khjtony/UCDDatalogger/Reporters/March27.pdf

# Data Logger Report

### Tony Kang

### April 4, 2014

## Contents

1 summary | 2
2 Schedule | 3

1

## 1 summary

Now, we have two types of data loggers in testing. One is Arduino UNO with Data Logging shield made by Adafruit. Another one is Arduino Pro mini with some external modules. ”Bare Bone circuit” is not in working now.

### 1.1 UNO with Data logging Shield

Till now, we have a full features data logger which is ”UNO with Data Logging shield”.

1. Advantages:
- It is fast to develop.
- Because this logger is combination of pre-built components, it is more stable during test.
- It can simply mount most of the components on the shield.
2. Disadvantages
- It uses much power, because UNO consume much power and Real Time clock on the Data Logging Shield cannot be shutdown. This system consumes around 50mA during waking up and 30mA during sleeping.
- It has large size.
3. TO-DO:
- Conduct reliable test under different circumsphere, and enhance its robust.

However, generally speaking, this system is good during developing.

### 1.2 Pro Mini with external moduels

Till now, this data logger has full featured program, and its abilities recording 5TE data and battery voltage has been examined, but it has one more test about recording data from ADC circuit.

1. Advantages:
- It consumes less power. One is because that I can manually shutdown external modules including ADC circuit, sensors and Real Time Clock module, which consumes 4mA.

2

- It has flexible physical size, which depends on how we finally put them together.
2. Disadvantages
- It need work when poring program from ”UNO+Shield” to this system.
- It cost more time in debugging.
3. TO-DO:
- Debugging, making system more robust, and conduct reliable test.

## 2 Schedule

1. During spring break, finish of ”UNO with Shield” and upload record.
2. Before April.6, finish debugging of Pro Mini controller and begin robust test.

3
