khjtony/UCDDatalogger/documents/figures/conBrd.png

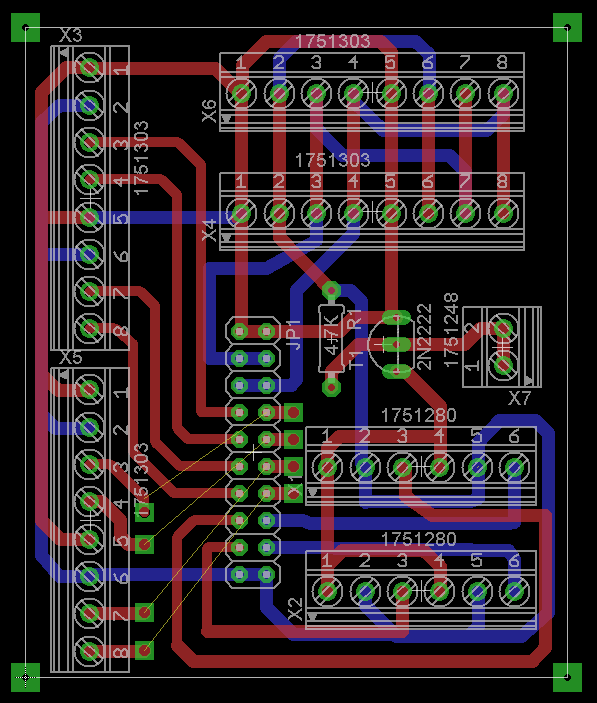
documents/figures/conBrd.png
