khjtony/UCDDatalogger/documents/figures/func_board_top.png

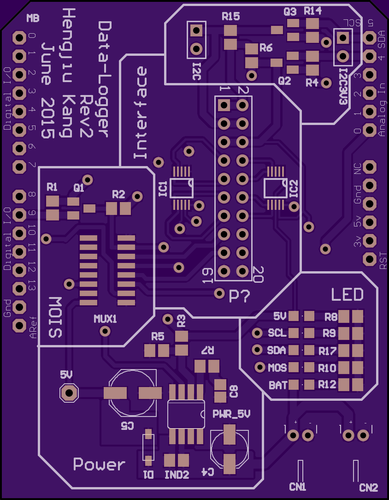
documents/figures/func_board_top.png
