khjtony/UCDDatalogger/documents/figures/uc-davis.jpg

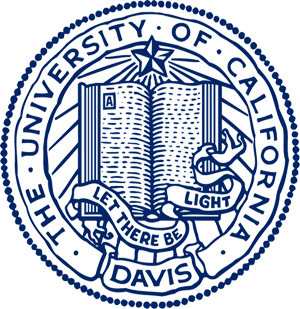
documents/figures/uc-davis.jpg
