khjtony/UCDDatalogger/EthernetShield/H.jpg

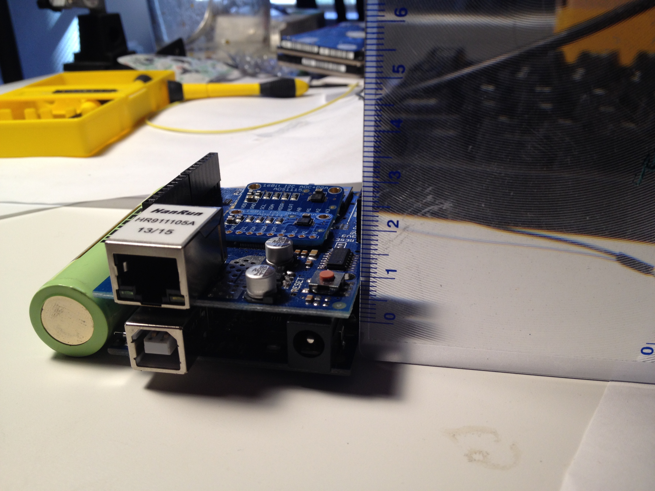
EthernetShield/H.jpg
