khjtony/UCDDatalogger/EthernetShield/L.jpg

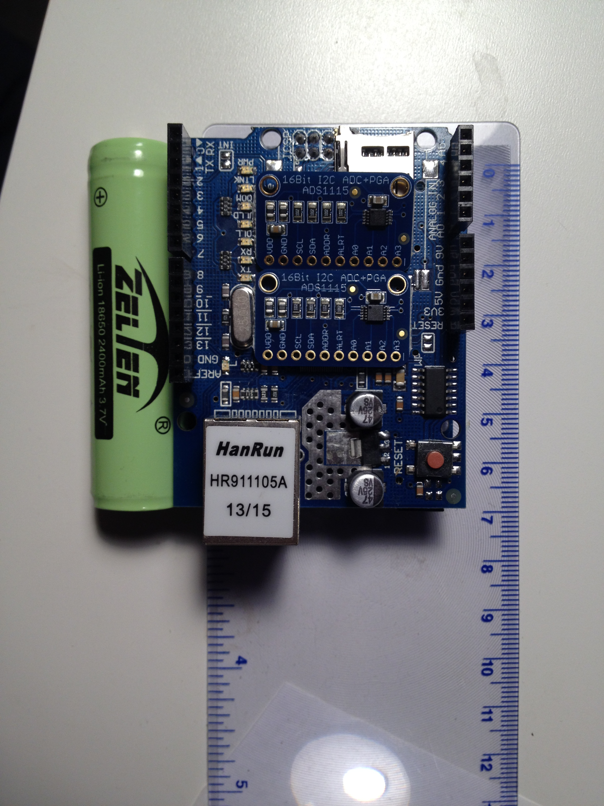
EthernetShield/L.jpg
