khjtony/UCDDatalogger/EthernetShield/W.jpg

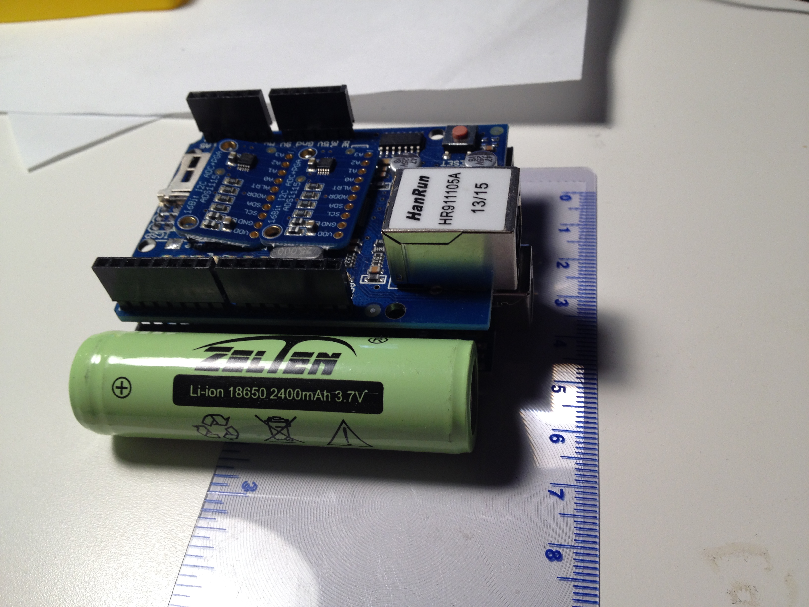
EthernetShield/W.jpg
