khjtony/UCDDatalogger/Reporters/DSC_0035.jpg

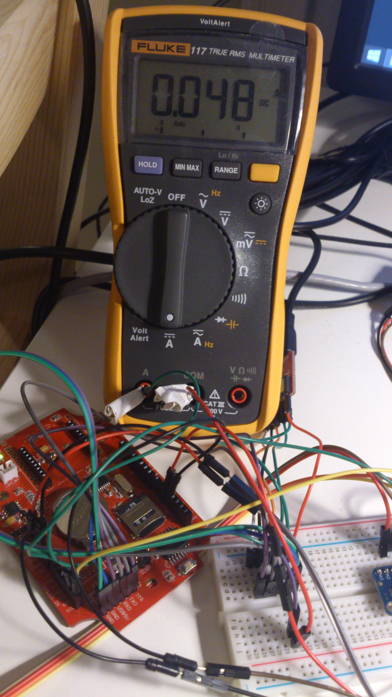
Reporters/DSC_0035.jpg
