khjtony/UCDDatalogger/Reporters/DSC_0037.jpg

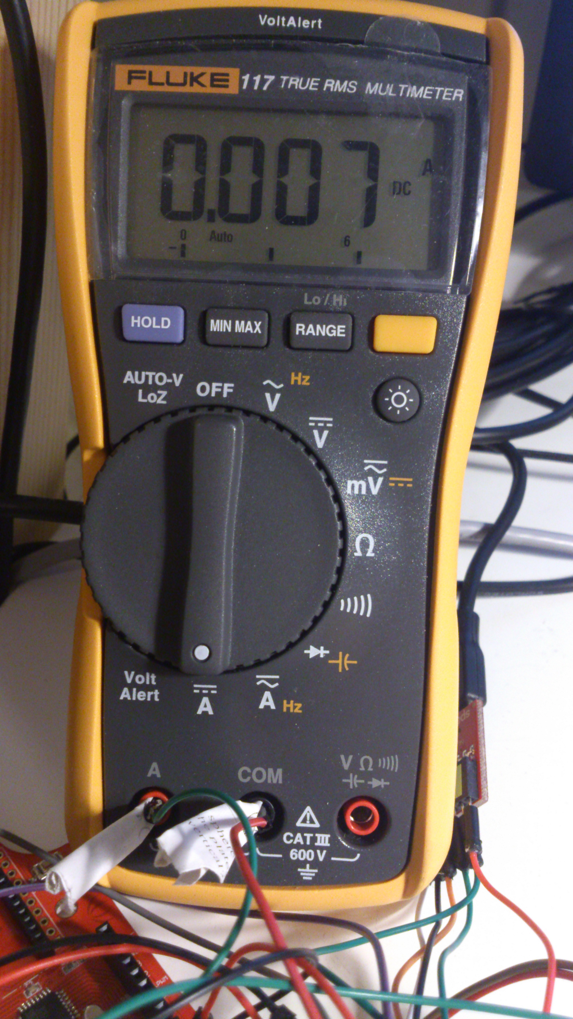
Reporters/DSC_0037.jpg
