khjtony/UCDDatalogger/ShieldBackV01.jpeg

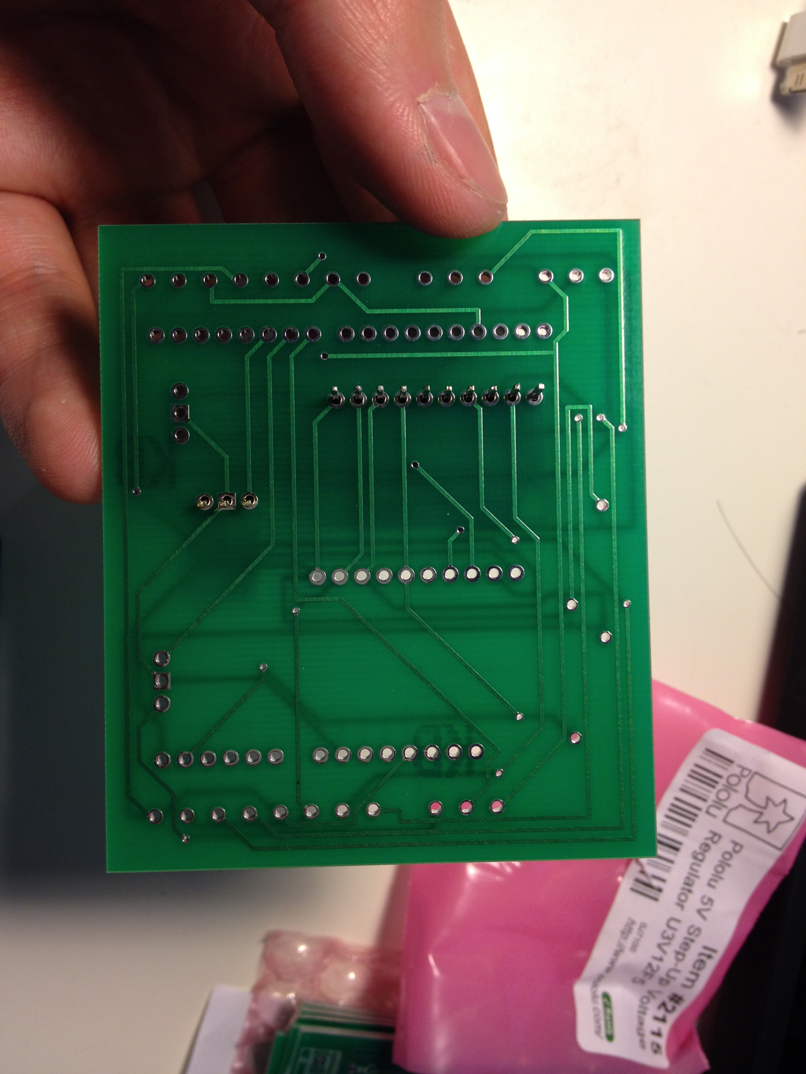
ShieldBackV01.jpeg
