khjtony/UCDDatalogger/XBee900HP.jpg

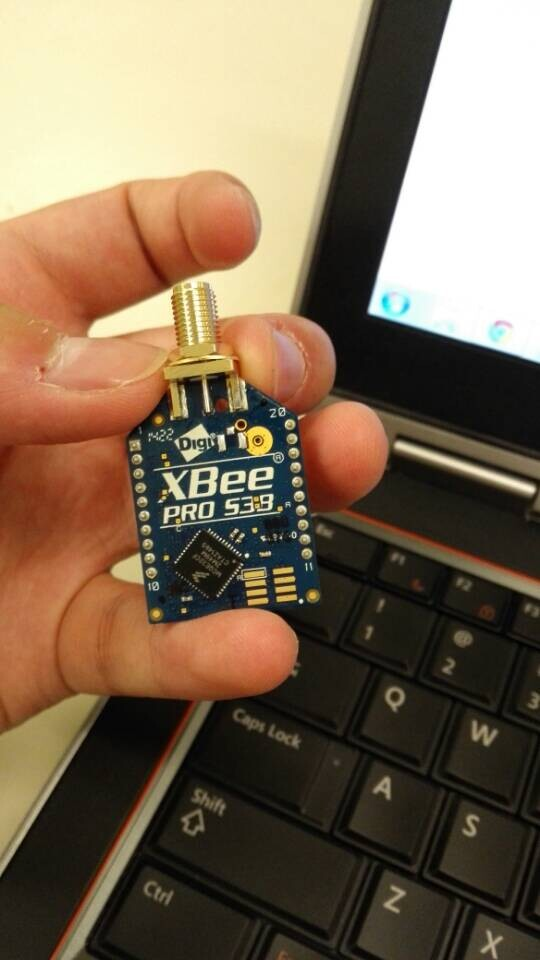
XBee900HP.jpg
