khjtony/UCDDatalogger/xbeeAPItest/allData.png

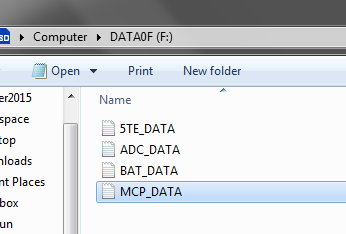
xbeeAPItest/allData.png
