khjtony/UCDDatalogger/documents/BOM_NaughtyBall.xlsx

BOM of Naughty Ball
 |  | Inspection Bill of Materials for : (insert team name/number)
 | Team: | (insert team name) | Team #: |  | Date:
 |  |  | City: |  |  | State:
Item |  | Description | Raw Mat'l | Source | Qty | Unit of Meas | Unit Price ($) | Total Price
Major System Names Here |  | Describe the Part (Axle, Bearing, Lifter, Solenoid) | What is it made from | Where did you buy it (Home Depot, AndyMark, Supply House, Etc.) | How Many | Piece, Inch, Etc. | Cost Per Unit
Controllers:
BeagleBone Black |  | Beaglebone Black Controller |  | Element 14 | 1 |  | $57.99 | $57.99
Arduino Pro Mini |  | Co-processor |  | Adafruit | 1 |  | $9.95 | $9.95
Trinket |  | Co-processor |  | Adafruit | 1 |  | $6.95 | $6.95
 |  |  |  |  |  |  |  | $0.00
 |  |  |  |  |  |  |  | $0.00
 |  |  |  |  |  |  |  | $0.00
 |  |  |  |  |  |  |  | $0.00
 |  |  |  |  |  |  |  | $0.00
 |  |  |  |  |  |  | Subtotals: | $74.89
Sensors
GY-521 |  | IMU from InvenSense |  | Amazon | 1 |  | $5.54 | $5.54
GY-271 |  | Magnetometer from Honeywell |  | Amazon | 1 |  | $5.99 | $5.99
SEN0158 |  | Infrared Cameras |  | DFRobot | 4 |  | $23.55 | $94.20
TSSP4P38 |  | Proximity Sensor |  | Digikey | 8 |  | $1.04 | $8.32
IR67-21C |  | Infrared LED |  | Digikey | 24 |  | $0.21 | $5.04
TCA9548A |  | I2C Mux |  | Digikey | 1 |  | $2.47 | $2.47
LP5907 |  | 3V3 regulator |  | Digikey | 2 |  | $0.61 | $1.22
ADS1015 |  | ADC from TI |  | Digikey | 2 |  | $2.98 | $5.96
LTC4301L |  | I2C Level shift&buffer |  | Digikey | 2 |  | $4.02 | $8.04
 |  |  |  |  |  |  | Subtotals: | $136.78
Mechanical
Transfer unit |  | Ball transfer unit |  | Taobao | 6 |  | $1.60 | $9.60
Transparent Plastic ball |  |  |  | Ebay | 1 |  | $4.00 | $4.00
Plastic Sheet |  | ABS Sheet 200x200x4 mm |  | Taobao | 1 |  | $1.90 | $1.90
Aluminium Sheet |  | Aluminium Sheet 4''x4'' (pack of 6) |  | Taobao | 1 |  | $11.60 | $11.60
Aluminium Sheet |  | Aluminium Sheet 4''x10'x0.064'' |  | Taobao | 1 |  | $3.99 | $3.99
Coupling nuts |  | 8/32 diameter coupling nut |  | Ace Hardware | 4 |  | $0.47 | $1.86
Aluminium Rod |  |  |  | Ace Hardware | 1 |  | $5.65 | $5.65
 |  |  |  |  |  |  |  | $0.00
 |  |  |  |  |  |  | Subtotals: | $38.60
Mobility
Servo Motor |  | Micro Servo Motor |  | Adafruit | 1 |  | $5.95 | $5.95
NCR18650B |  | 3.7V Li-ion battery |  | Amazon | 6 |  | $9.47 | $56.82
Stepper Motor |  | Shinano Kenshi Stepper Motor |  | Taobao | 2 |  | $10.10 | $20.20
Stepper Motor Driver Board |  | TB6560 |  | Taobao | 2 |  | $4.50 | $9.00
 |  |  |  |  |  |  |  | $0.00
 |  |  |  |  |  |  |  | $0.00
 |  |  |  |  |  |  |  | $0.00
 |  |  |  |  |  |  |  | $0.00
 |  |  |  |  |  |  | Subtotals: | $91.97
PCB and Other
Shield |  | Shield PCB |  | Bay Area Circuit | 1 |  | $30.00 | $30.00
Ankle Band LED |  | PCB for Ankle band LED |  | Bay Area Circuit | 1 |  | $30.00 | $30.00
NeoPixel |  | LED Strip |  | Adafruit | 4 |  | $9.95 | $39.80
3D print fillment |  | PLA 3D printing fillment |  | Ebay | 1 |  | $20.00 | $20.00
Ankle Band Driver |  | PCB for driving LEDs |  | Bay Area Circuit | 1 |  | $30.00 | $30.00
LM2596 |  | Adjustable Swtich Regulator |  | Taobao | 1 |  | $0.50 | $0.50
 |  |  |  |  |  |  |  | $0.00
 |  |  |  |  |  |  |  | $0.00
 |  |  |  |  |  |  | Subtotals: | $150.30
 |  |  |  |  |  |  | Totals: | $492.54
