khjtony/UCDDatalogger/(list of files, drawings)

Other design files:
KLogShield/KLogShield/interfaceBoard.SchDoc
KLogShield/KLogShield/KLogShield.PcbDoc
KLogShield/KLogShield/KLogShield.PrjPcb
KLogShield/KLogShield/KLogShield.SchDoc
KLogShield/KLogShield/KLogShield_MB_Rev1.PcbDoc
KLogShield/KLogShield/KLogShield_Rev1.SchDoc
KLogShield/KLogShield/shield_main.SchDoc
KLogShield/KLogShield/sub_moisture.SchDoc
KLogShield/KLogShield/sub_pressure.SchDoc
KLogShield/KLogShield/sub_temperature.SchDoc
KLogShield/KLogShield_Interface_Rev1/KLogShield_Interface_Rev1.PrjPcb
KLogShield/KLogShield_Interface_Rev1/KLogShield_Interface_Rev1.SchDoc
MUXShield/MUXShield.DSN
MUXShield/MUXShield.pdsprj
