khjtony/UCDDatalogger/KLogShield/InterfaceEagle/interfaceBoard.brd

## EAGLE design KLogShield/InterfaceEagle/interfaceBoard.brd (2015-07-22)

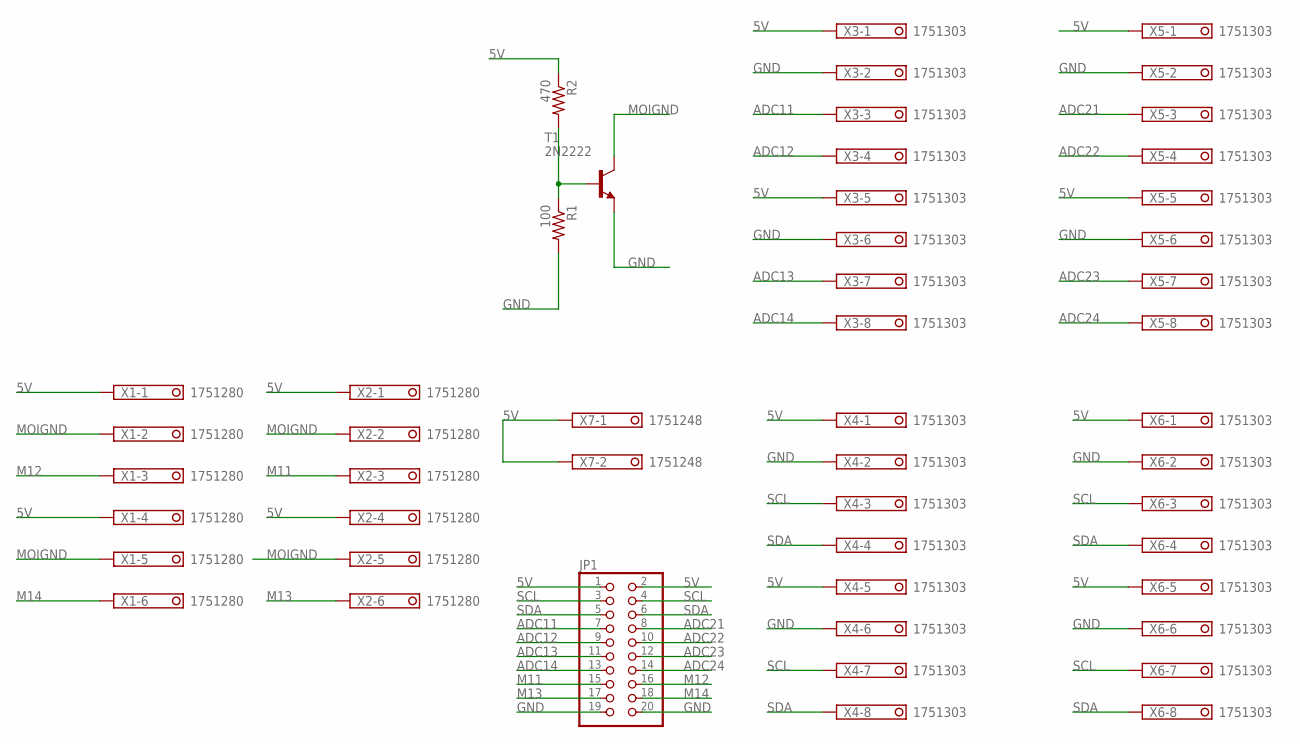
[picture p32: schematic interfaceBoard.sch]

Parts:
JP1: PINHD-2X10; 2X10
R1: 100; M0805
R2: 470; M0805
T1: 2N2222; TO92-EBC-OVAL
X1, X2: 1751280
X3, X4, X5, X6: 1751303
X7: 1751248

Connections:
5V: JP1.1, JP1.2, R2.1, X1.1, X1.4, X2.1, X2.4, X3.1, X3.5, X4.1, X4.5, X5.1, X5.5, X6.1, X6.5, X7.1, X7.2
ADC11: JP1.7, X3.3
ADC12: JP1.9, X3.4
ADC13: JP1.11, X3.7
ADC14: JP1.13, X3.8
ADC21: JP1.8, X5.3
ADC22: JP1.10, X5.4
ADC23: JP1.12, X5.7
ADC24: JP1.14, X5.8
GND: JP1.19, JP1.20, R1.2, T1.E, X3.2, X3.6, X4.2, X4.6, X5.2, X5.6, X6.2, X6.6
M11: JP1.15, X2.3
M12: JP1.16, X1.3
M13: JP1.17, X2.6
M14: JP1.18, X1.6
MOIGND: T1.C, X1.2, X1.5, X2.2, X2.5
unnamed: R1.1, R2.2, T1.B
SCL: JP1.3, JP1.4, X4.3, X4.7, X6.3, X6.7
SDA: JP1.5, JP1.6, X4.4, X4.8, X6.4, X6.8

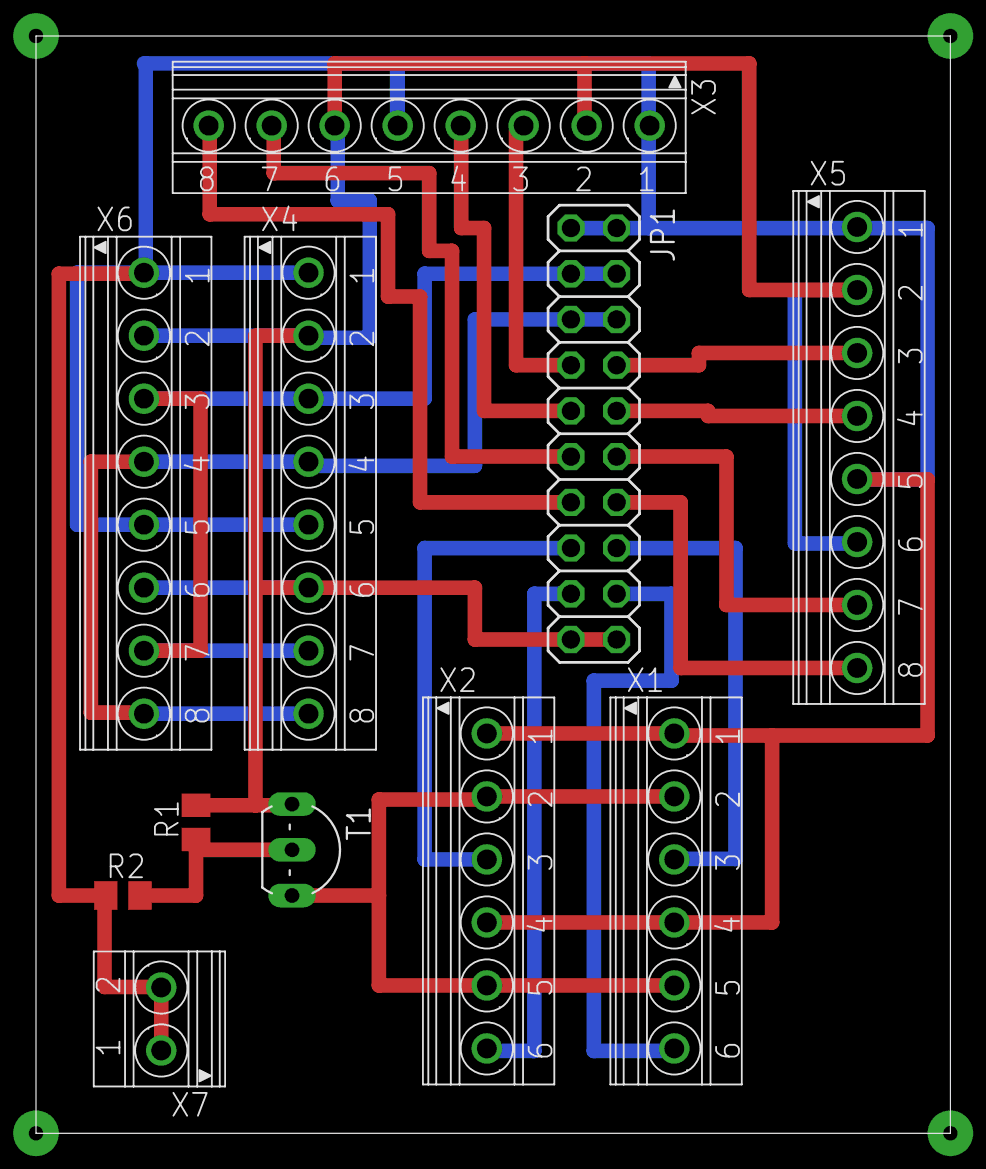
[picture p33: board interfaceBoard.brd from above]

Board: 2 copper layers, 50.8 x 61.0 mm, 11 parts (0 on the bottom side), 18 nets.
