khjtony/UCDDatalogger/xbeeAPItest/apiTest/apiTest.ino

byte data[35]={0x7e,0x00,0x1F,0x10,0x01,0x00,0x13,0xa2,0x00,0x40,0xc8,0x4f,0xc7,0xFF,0xFE,0x00,0x00,0x6D,0x65,0x73,0x73,0x61,0x67,0x65,0x20,0x73,0x65,0x6E,0x74,0x20,0x74,0x65,0x73,0x74,0x7f};

void setup(){
  Serial.begin(19200);
//  Serial1.begin(19200);
}

void loop(){
  for (int i=0;i<35;i++){
//    Serial.print(data[i],HEX);
//    Serial.print(' ');
    Serial.write(data[i]);
  }
//  Serial.println("");
  delay(1000);
}
