khjtony/UCDDatalogger/(commit log)

2015-02-02 initialize new repo for current project
    [MUXShield.DSN, MUXShield.pdsprj]
2015-02-22 added frame sample
2015-02-22 start klog
    [KLogShield.PrjPcb, KLogShield.SchDoc, shield_main.SchDoc, sub_moisture.SchDoc, sub_pressure.SchDoc, sub_temperature.SchDoc]
2015-03-27 new k shield
    [KLogShield.PrjPcb, KLogShield.SchDoc]
2015-03-30 new generation of logger software
    [KLogShield.GBL, KLogShield.GBO, KLogShield.GBP, KLogShield.GBS, KLogShield.GKO, KLogShield.GM1, KLogShield.GTL, KLogShield.GTO]
2015-07-05 klogshield revison 2
    [KLogShield.PcbDoc, KLogShield.PrjPcb, KLogShield_Interface_Rev1.PrjPcb, KLogShield_Interface_Rev1.SchDoc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]
2015-07-06 need to finish coordinator
    [Stalker v2.3.brd, Stalker v2.3.sch]
2015-07-22 klog interface board gen2
    [interfaceBoard.brd, interfaceBoard.sch]
