khjtony/UCDDatalogger/Reporters/DSC_0036.jpg

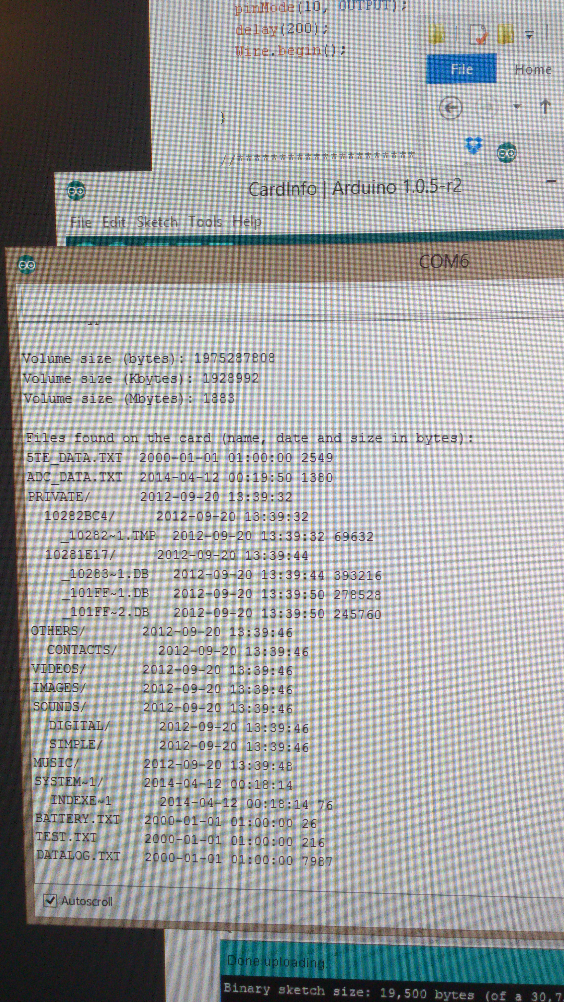
Reporters/DSC_0036.jpg
