khjtony/UCDDatalogger/Reporters/DSC_0038.jpg

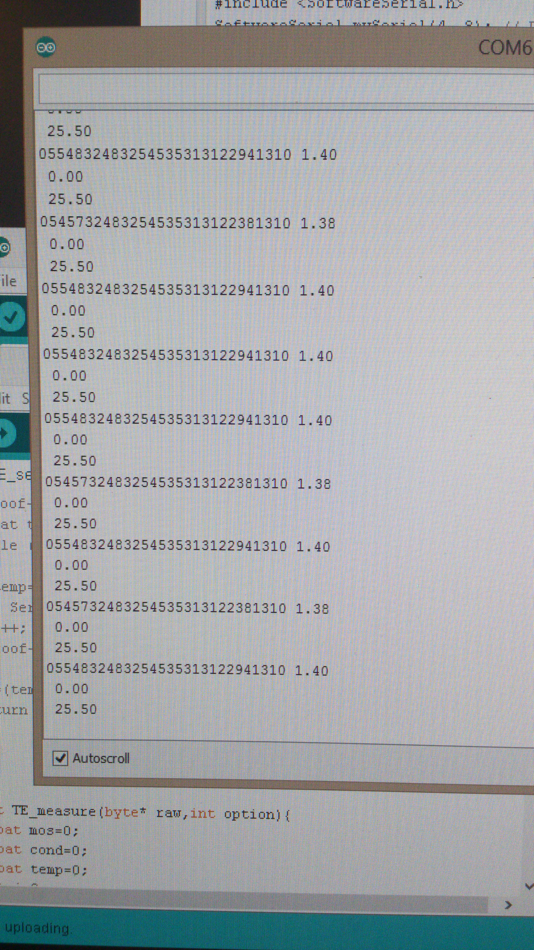
Reporters/DSC_0038.jpg
